reyantonalvaro/ELE0124CL/power_buck/ELE0124CL_power_buck/ELE0124CL_power_buck.kicad_pcb

## KiCad design power_buck/ELE0124CL_power_buck/ELE0124CL_power_buck.kicad_pcb (2024-08-10)

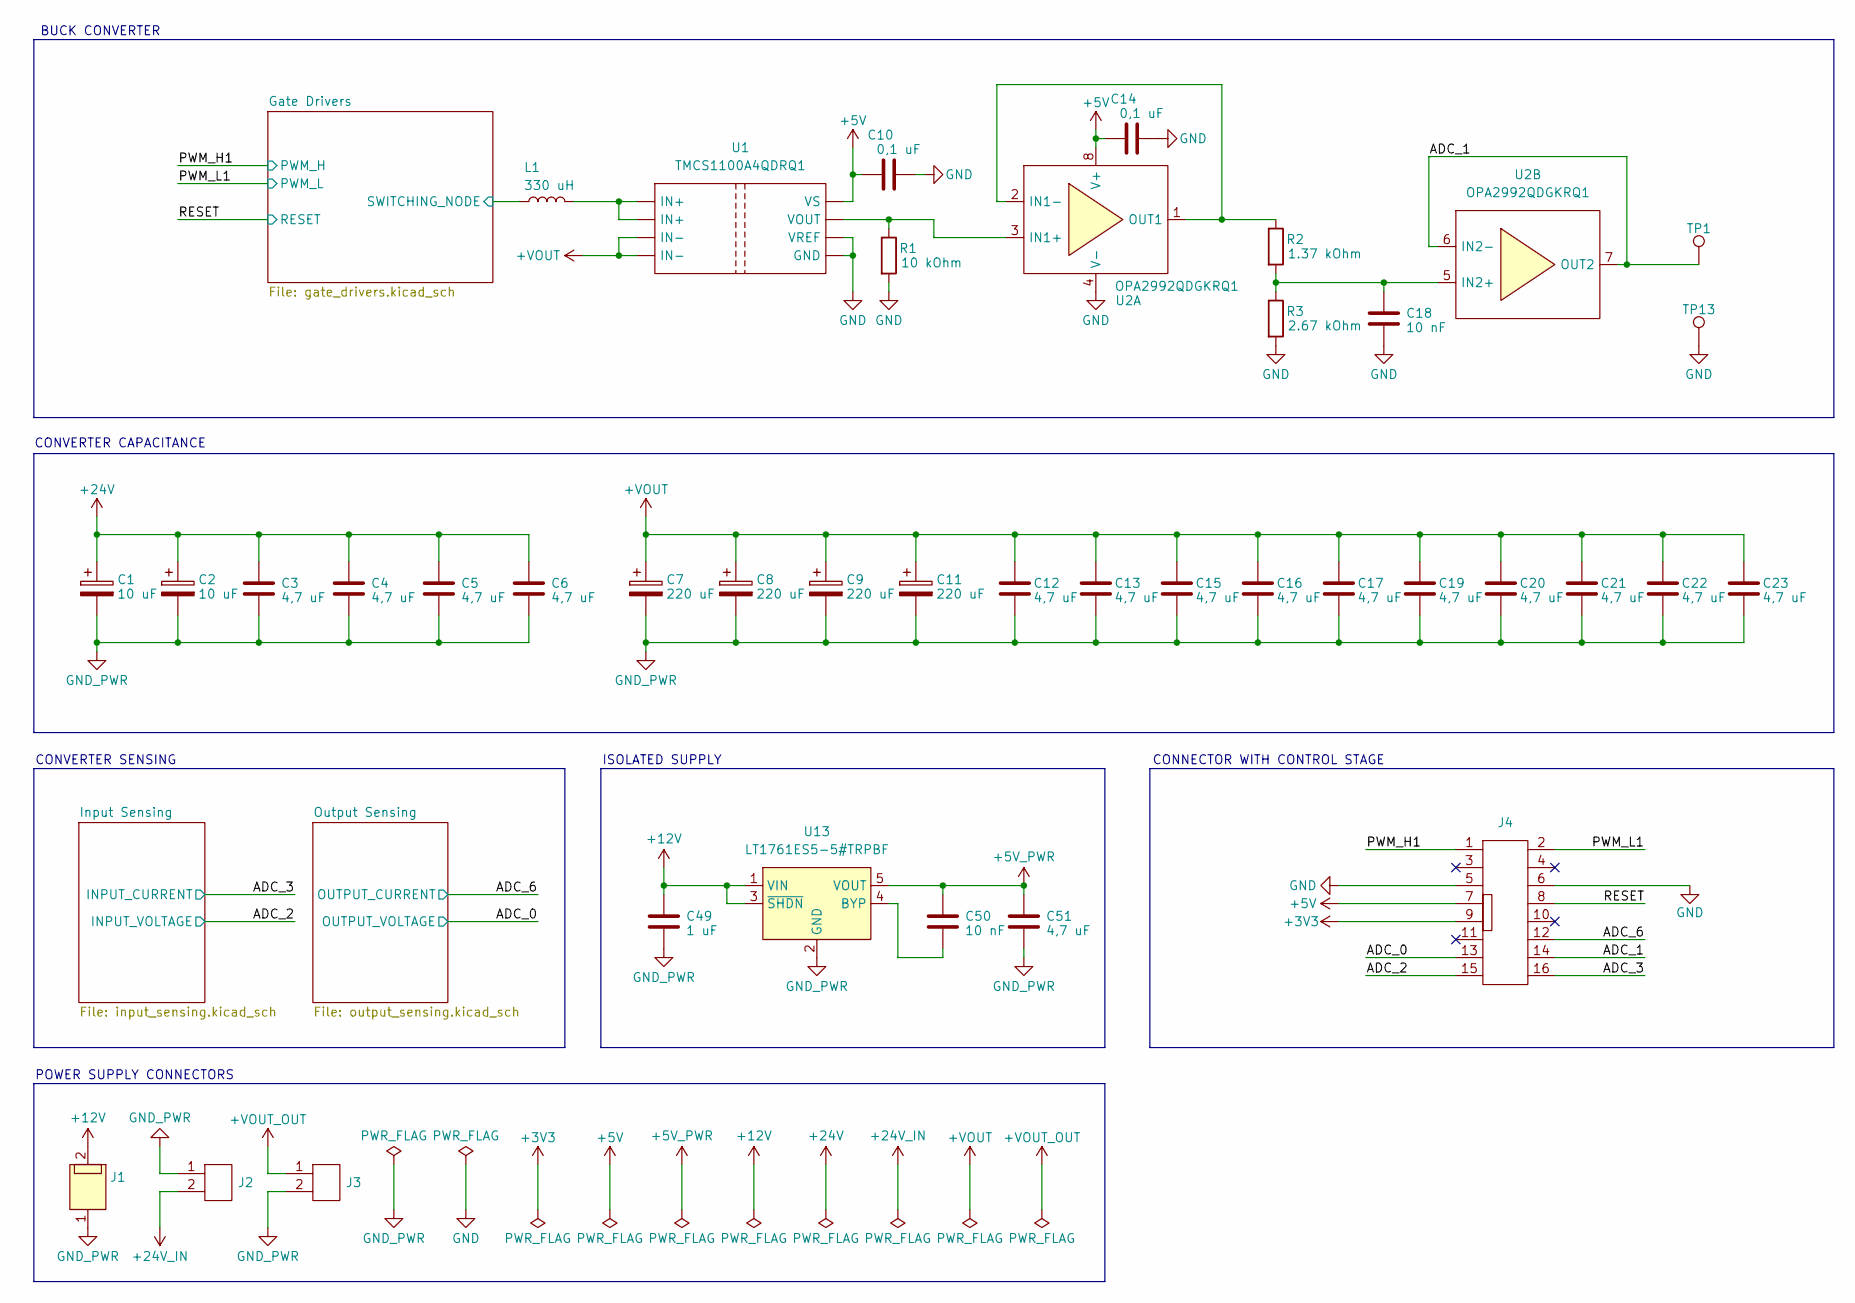
[picture p1: schematic ELE0124CL_power_buck.kicad_sch, ELE0124CL Power Buck Development Kit]

Parts:
C1, C2: 10 uF; C_D5.0mm_H11.0mm_P2.00mm
C3, C4, C5, C6, C12, C13, C15, C16, C17, C19, C20, C21, C22, C23, C51: 4,7 uF; C_1206_3216Metric
C7, C8, C9, C11: 220 uF; C_D10.0mm_H16.0mm_P5.00mm
C10, C14: 0,1 uF; C_0603_1608Metric
C18, C50: 10 nF; C_0603_1608Metric
C49: 1 uF; C_1206_3216Metric
J1: 43045-0212; CONN_SOCKET_1x02_P3.00mm_Vertical
J2, J3: MSTBVA 2,5/ 2-G-5,08; CONN_TERMINAL_BLOCK_1x02_P5.08mm_Vertical
J4: 878311620; CONN_SOCKET_2x08_P2.00mm_Vertical
L1: 330 uH; L_74437529203331
R1: 10 kOhm; R_0603_1608Metric
R2: 1.37 kOhm; R_0603_1608Metric
R3: 2.67 kOhm; R_0603_1608Metric
TP1, TP13: TP_THT
U1: TMCS1100A4QDRQ1; SOIC-8_5.40mm_P1.27mm
U2: OPA2992QDGKRQ1; VSSOP-8_4.40mm_P0.65mm
U13: LT1761ES5-5#TRPBF; TSOT-23-5

Connections:
+3V3: J4.9; also elsewhere on the board
+5V: C10.1, C14.1, J4.7, U1.8 (VS), U2.8 (V+); also elsewhere on the board
+5V_PWR: C50.1, C51.1, U13.5 (VOUT); also elsewhere on the board
+12V: C49.1, J1.2, U13.1 (VIN), U13.3 (~SHDN); also elsewhere on the board
+24V: C1.1, C2.1, C3.1, C4.1, C5.1, C6.1; also elsewhere on the board
+24V_IN: J2.2; also elsewhere on the board
+VOUT: C7.1, C8.1, C9.1, C11.1, C12.1, C13.1, C15.1, C16.1, C17.1, C19.1, C20.1, C21.1, C22.1, C23.1, U1.3 (IN-), U1.4 (IN-); also elsewhere on the board
+VOUT_OUT: J3.1; also elsewhere on the board
/ADC_0: J4.13; also elsewhere on the board
/ADC_1: J4.14, TP1.1 (TP), U2.6 (IN2-), U2.7 (OUT2)
/ADC_2: J4.15; also elsewhere on the board
/ADC_3: J4.16; also elsewhere on the board
/ADC_6: J4.12; also elsewhere on the board
/Gate Drivers/SWITCHING_NODE: L1.1; also elsewhere on the board
/PWM_H1: J4.1; also elsewhere on the board
/PWM_L1: J4.2; also elsewhere on the board
/RESET: J4.8; also elsewhere on the board
GND: C10.2, C14.2, C18.2, J4.5, J4.6, R1.2, R3.2, TP13.1 (TP), U1.5 (GND), U1.6 (VREF), U2.4 (V-); also elsewhere on the board
GND_PWR: C1.2, C2.2, C3.2, C4.2, C5.2, C6.2, C7.2, C8.2, C9.2, C11.2, C12.2, C13.2, C15.2, C16.2, C17.2, C19.2, C20.2, C21.2, C22.2, C23.2, C49.2, C51.2, J1.1, J2.1, J3.2, U13.2 (GND); also elsewhere on the board
unnamed: L1.2, U1.1 (IN+), U1.2 (IN+)
unnamed: R1.1, U1.7 (VOUT), U2.3 (IN1+)
unnamed: R2.1, U2.1 (OUT1), U2.2 (IN1-)
unnamed: C18.1, R2.2, R3.1, U2.5 (IN2+)
unnamed: C50.2, U13.4 (BYP)

Notes on the sheet:
CONNECTOR WITH CONTROL STAGE
CONVERTER CAPACITANCE
CONVERTER SENSING
BUCK CONVERTER
ISOLATED SUPPLY
POWER SUPPLY CONNECTORS

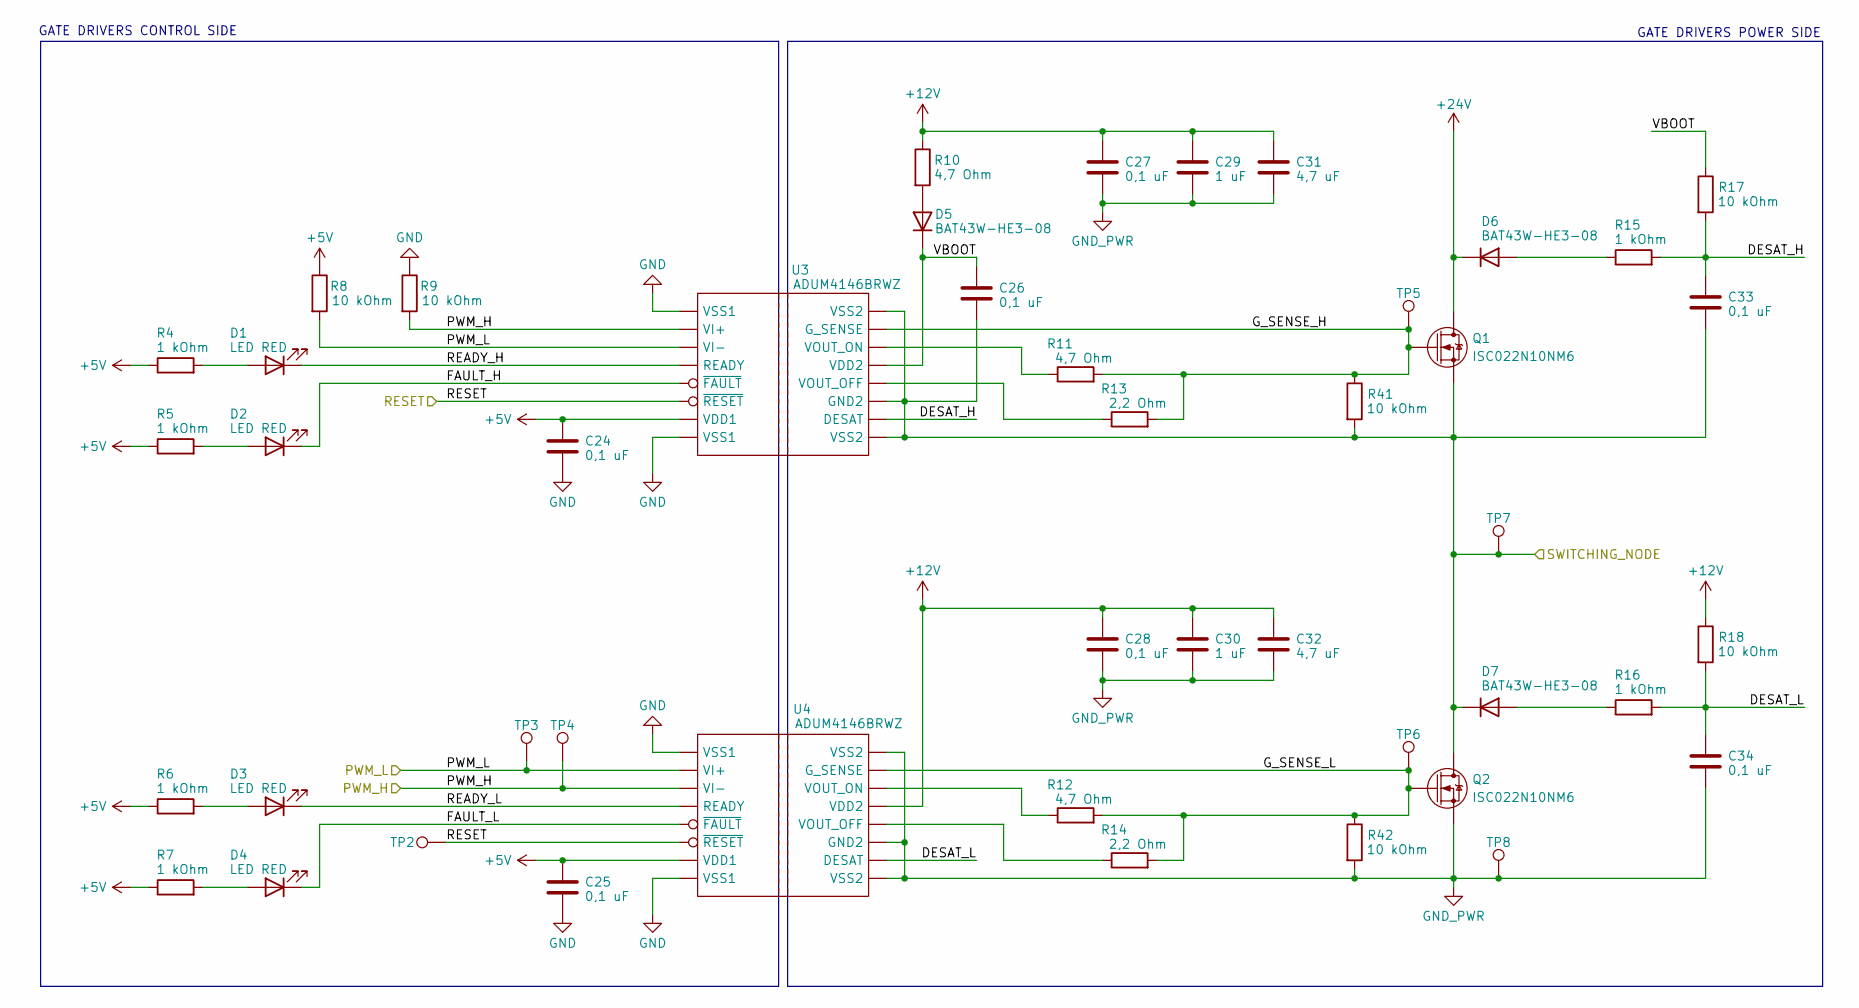
[picture p2: schematic gate_drivers.kicad_sch, ELE0124CL Power Buck Gate Drivers]

Parts:
C24, C25, C27, C28, C33, C34: 0,1 uF; C_0603_1608Metric
C26: 0,1 uF; C_1206_3216Metric
C29, C30: 1 uF; C_1206_3216Metric
C31, C32: 4,7 uF; C_1206_3216Metric
D1, D2, D3, D4: LED RED; D_0603_1608Metric
D5, D6, D7: BAT43W-HE3-08; D_SOD-123
Q1, Q2: ISC022N10NM6; PG-TDSON-8-3
R4, R5, R6, R7, R15, R16: 1 kOhm; R_0603_1608Metric
R8, R9, R17, R18, R41, R42: 10 kOhm; R_0603_1608Metric
R10, R11, R12: 4,7 Ohm; R_2512_6332Metric
R13, R14: 2,2 Ohm; R_2512_6332Metric
TP2, TP3, TP4: TP_D1.0mm
TP5, TP6, TP7, TP8: TP_THT
U3, U4: ADUM4146BRWZ; SOIC-16W_9.60mm_P1.27mm

Connections:
+5V: C24.1, C25.1, R4.1, R5.1, R6.1, R7.1, R8.1, U3.7 (VDD1), U4.7 (VDD1); also elsewhere on the board
+12V: C27.1, C28.1, C29.1, C30.1, C31.1, C32.1, R10.1, R18.1, U4.13 (VDD2); also elsewhere on the board
+24V: D6.1 (K), Q1.3 (D); also elsewhere on the board
/Gate Drivers/DESAT_H: C33.1, R15.2, R17.2, U3.10 (DESAT)
/Gate Drivers/DESAT_L: C34.1, R16.2, R18.2, U4.10 (DESAT)
/Gate Drivers/FAULT_H: D2.1 (K), U3.5 (~FAULT)
/Gate Drivers/FAULT_L: D4.1 (K), U4.5 (~FAULT)
/Gate Drivers/G_SENSE_H: Q1.2 (G), R11.2, R13.2, R41.1, TP5.1 (TP), U3.15 (G_SENSE)
/Gate Drivers/G_SENSE_L: Q2.2 (G), R12.2, R14.2, R42.1, TP6.1 (TP), U4.15 (G_SENSE)
/Gate Drivers/READY_H: D1.1 (K), U3.4 (READY)
/Gate Drivers/READY_L: D3.1 (K), U4.4 (READY)
/Gate Drivers/SWITCHING_NODE: C26.2, C33.2, D7.1 (K), Q1.1 (S), Q2.3 (D), R41.2, TP7.1 (TP), U3.9 (VSS2), U3.11 (GND2), U3.16 (VSS2); also elsewhere on the board
/Gate Drivers/VBOOT: C26.1, D5.1 (K), R17.1, U3.13 (VDD2)
/PWM_H1: R9.2, TP4.1 (TP), U3.2 (VI+), U4.3 (VI-); also elsewhere on the board
/PWM_L1: R8.2, TP3.1 (TP), U3.3 (VI-), U4.2 (VI+); also elsewhere on the board
/RESET: TP2.1 (TP), U3.6 (~RESET), U4.6 (~RESET); also elsewhere on the board
GND: C24.2, C25.2, R9.1, U3.1 (VSS1), U3.8 (VSS1), U4.1 (VSS1), U4.8 (VSS1); also elsewhere on the board
GND_PWR: C27.2, C28.2, C29.2, C30.2, C31.2, C32.2, C34.2, Q2.1 (S), R42.2, TP8.1 (TP), U4.9 (VSS2), U4.11 (GND2), U4.16 (VSS2); also elsewhere on the board
unnamed: D1.2 (A), R4.2
unnamed: D2.2 (A), R5.2
unnamed: D3.2 (A), R6.2
unnamed: D4.2 (A), R7.2
unnamed: D5.2 (A), R10.2
unnamed: D6.2 (A), R15.1
unnamed: D7.2 (A), R16.1
unnamed: R13.1, U3.12 (VOUT_OFF)
unnamed: R11.1, U3.14 (VOUT_ON)
unnamed: R14.1, U4.12 (VOUT_OFF)
unnamed: R12.1, U4.14 (VOUT_ON)

Notes on the sheet:
GATE DRIVERS CONTROL SIDE
GATE DRIVERS POWER SIDE

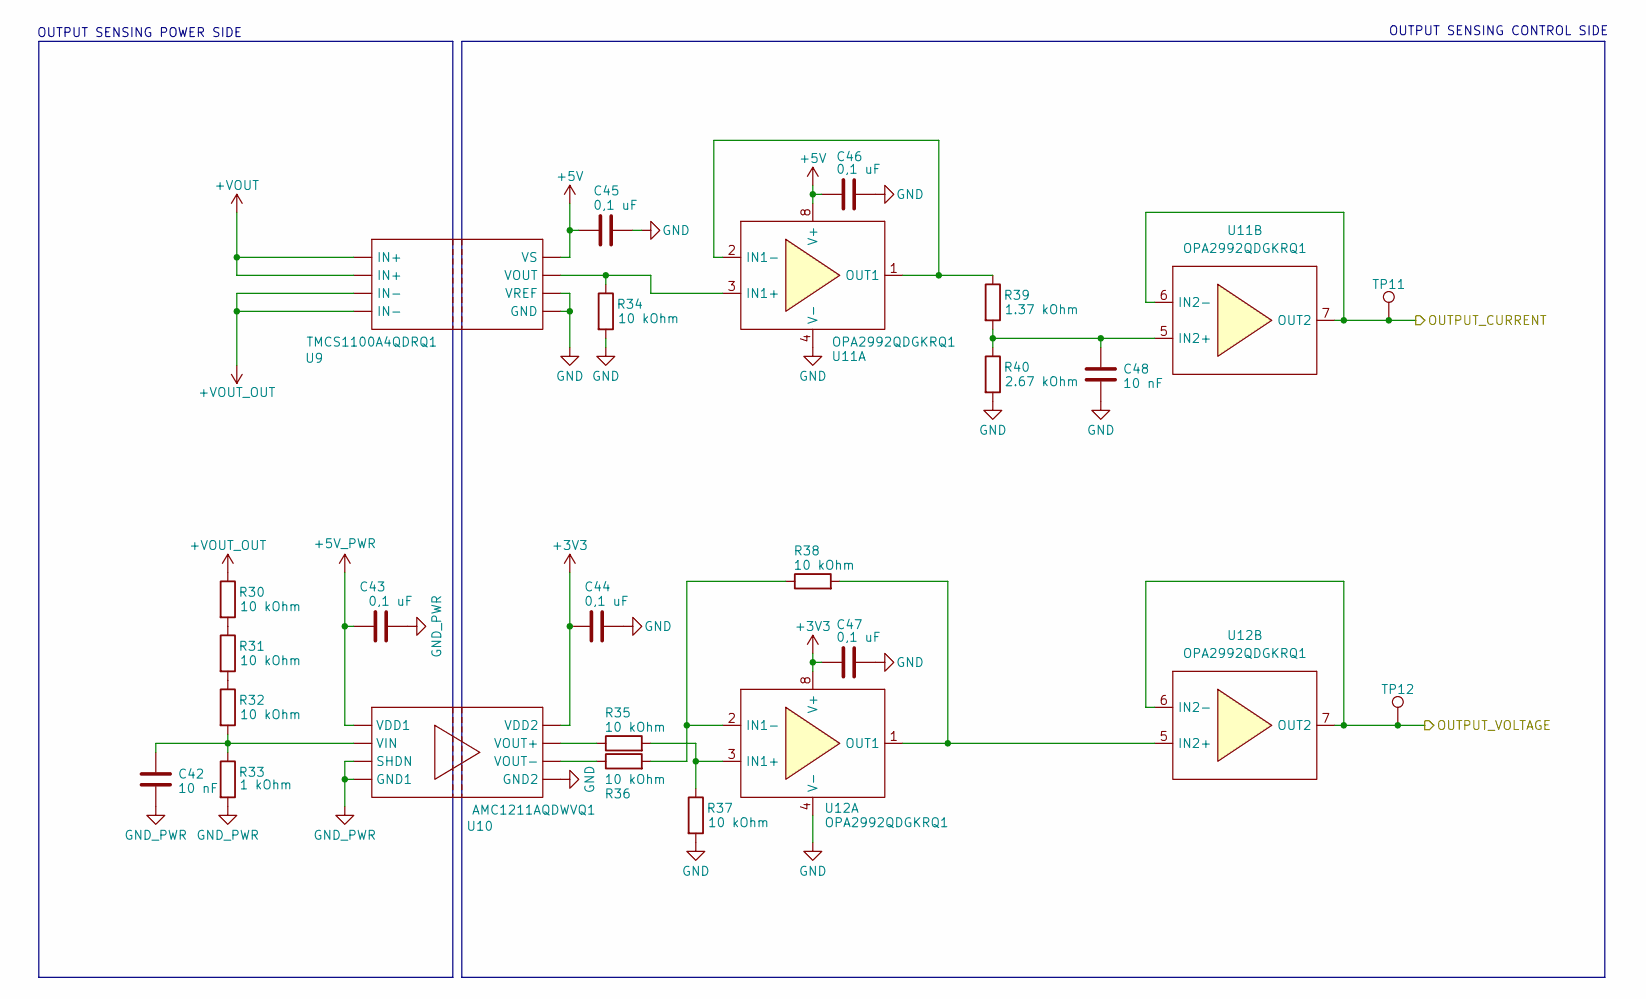
[picture p3: schematic output_sensing.kicad_sch, ELE0124CL Power Buck Output Sensing]

Parts:
C42, C48: 10 nF; C_0603_1608Metric
C43, C44, C45, C46, C47: 0,1 uF; C_0603_1608Metric
R30, R31, R32, R34, R35, R36, R37, R38: 10 kOhm; R_0603_1608Metric
R33: 1 kOhm; R_0603_1608Metric
R39: 1.37 kOhm; R_0603_1608Metric
R40: 2.67 kOhm; R_0603_1608Metric
TP11, TP12: TP_D1.0mm
U9: TMCS1100A4QDRQ1; SOIC-8_5.40mm_P1.27mm
U10: AMC1211AQDWVQ1; SSO-8_10.80mm_P1.27mm
U11, U12: OPA2992QDGKRQ1; VSSOP-8_4.40mm_P0.65mm

Connections:
+3V3: C44.1, C47.1, U10.8 (VDD2), U12.8 (V+); also elsewhere on the board
+5V: C45.1, C46.1, U9.8 (VS), U11.8 (V+); also elsewhere on the board
+5V_PWR: C43.1, U10.1 (VDD1); also elsewhere on the board
+VOUT: U9.1 (IN+), U9.2 (IN+); also elsewhere on the board
+VOUT_OUT: R30.1, U9.3 (IN-), U9.4 (IN-); also elsewhere on the board
/ADC_0: TP12.1 (TP), U12.6 (IN2-), U12.7 (OUT2); also elsewhere on the board
/ADC_6: TP11.1 (TP), U11.6 (IN2-), U11.7 (OUT2); also elsewhere on the board
GND: C44.2, C45.2, C46.2, C47.2, C48.2, R34.2, R37.2, R40.2, U9.5 (GND), U9.6 (VREF), U10.5 (GND2), U11.4 (V-), U12.4 (V-); also elsewhere on the board
GND_PWR: C42.2, C43.2, R33.2, U10.3 (SHDN), U10.4 (GND1); also elsewhere on the board
unnamed: R30.2, R31.1
unnamed: R31.2, R32.1
unnamed: C42.1, R32.2, R33.1, U10.2 (VIN)
unnamed: R35.1, U10.7 (VOUT+)
unnamed: R36.1, U10.6 (VOUT-)
unnamed: R34.1, U9.7 (VOUT), U11.3 (IN1+)
unnamed: R39.1, U11.1 (OUT1), U11.2 (IN1-)
unnamed: C48.1, R39.2, R40.1, U11.5 (IN2+)
unnamed: R35.2, R37.1, U12.3 (IN1+)
unnamed: R36.2, R38.1, U12.2 (IN1-)
unnamed: R38.2, U12.1 (OUT1), U12.5 (IN2+)

Notes on the sheet:
OUTPUT SENSING POWER SIDE
OUTPUT SENSING CONTROL SIDE

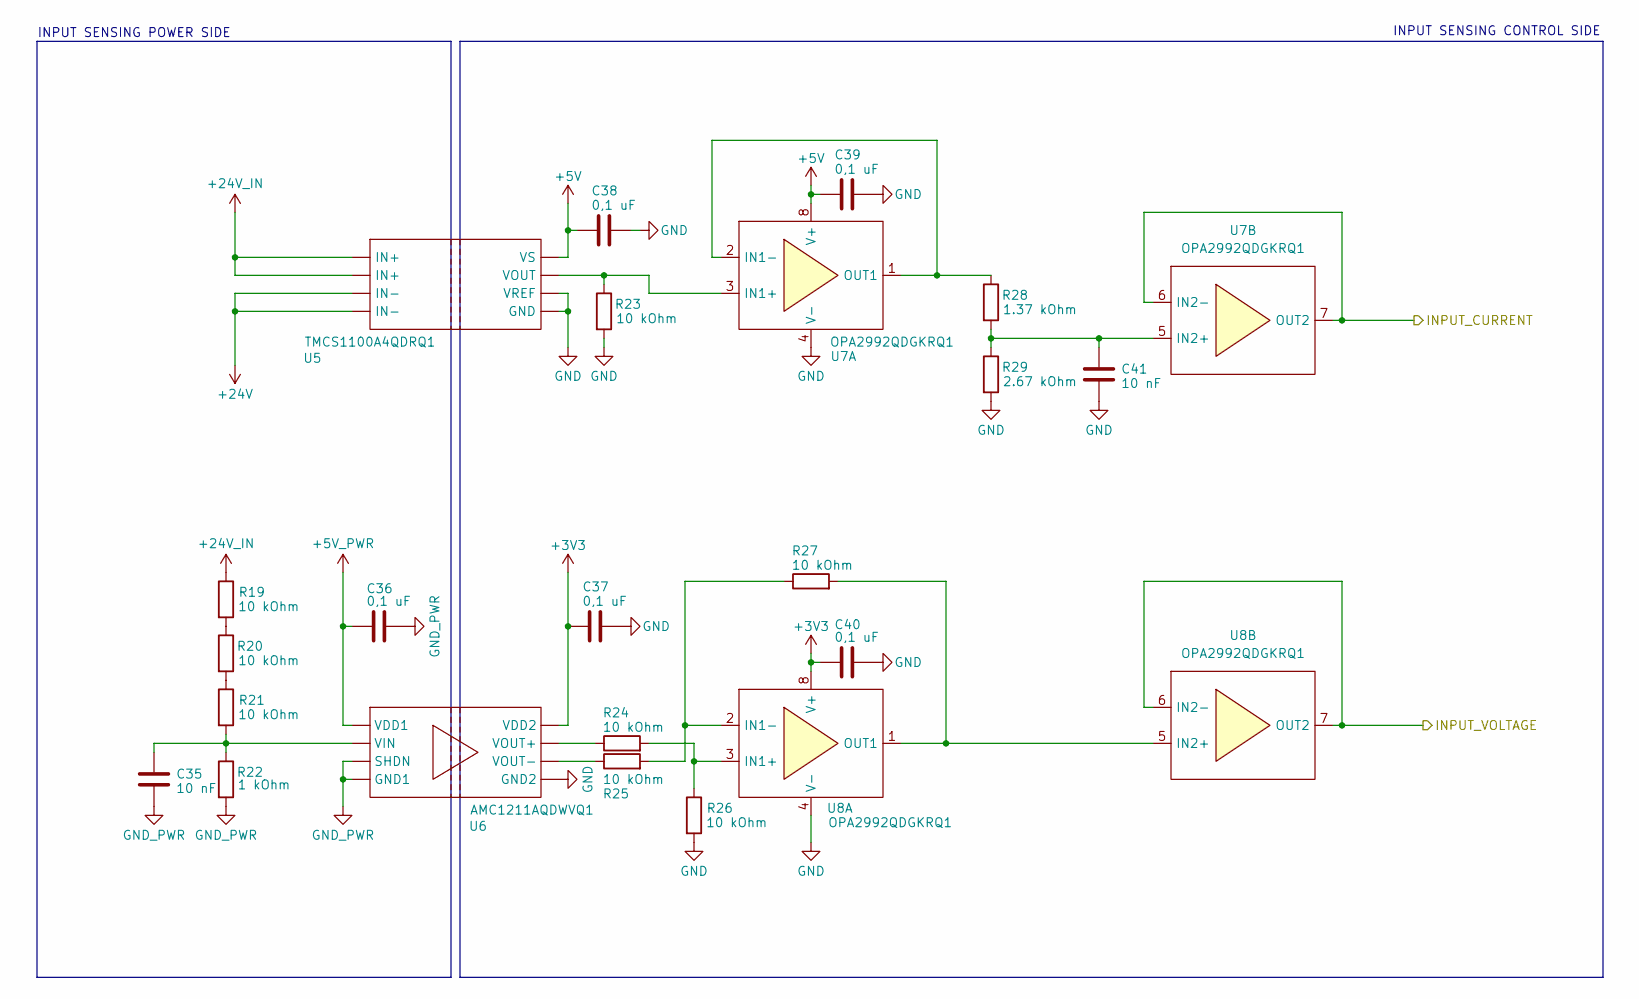
[picture p4: schematic input_sensing.kicad_sch, ELE0124CL Power Buck Input Sensing]

Parts:
C35, C41: 10 nF; C_0603_1608Metric
C36, C37, C38, C39, C40: 0,1 uF; C_0603_1608Metric
R19, R20, R21, R23, R24, R25, R26, R27: 10 kOhm; R_0603_1608Metric
R22: 1 kOhm; R_0603_1608Metric
R28: 1.37 kOhm; R_0603_1608Metric
R29: 2.67 kOhm; R_0603_1608Metric
U5: TMCS1100A4QDRQ1; SOIC-8_5.40mm_P1.27mm
U6: AMC1211AQDWVQ1; SSO-8_10.80mm_P1.27mm
U7, U8: OPA2992QDGKRQ1; VSSOP-8_4.40mm_P0.65mm

Connections:
+3V3: C37.1, C40.1, U6.8 (VDD2), U8.8 (V+); also elsewhere on the board
+5V: C38.1, C39.1, U5.8 (VS), U7.8 (V+); also elsewhere on the board
+5V_PWR: C36.1, U6.1 (VDD1); also elsewhere on the board
+24V: U5.3 (IN-), U5.4 (IN-); also elsewhere on the board
+24V_IN: R19.1, U5.1 (IN+), U5.2 (IN+); also elsewhere on the board
/ADC_2: U8.6 (IN2-), U8.7 (OUT2); also elsewhere on the board
/ADC_3: U7.6 (IN2-), U7.7 (OUT2); also elsewhere on the board
GND: C37.2, C38.2, C39.2, C40.2, C41.2, R23.2, R26.2, R29.2, U5.5 (GND), U5.6 (VREF), U6.5 (GND2), U7.4 (V-), U8.4 (V-); also elsewhere on the board
GND_PWR: C35.2, C36.2, R22.2, U6.3 (SHDN), U6.4 (GND1); also elsewhere on the board
unnamed: R19.2, R20.1
unnamed: R20.2, R21.1
unnamed: R23.1, U5.7 (VOUT), U7.3 (IN1+)
unnamed: C35.1, R21.2, R22.1, U6.2 (VIN)
unnamed: R24.1, U6.7 (VOUT+)
unnamed: R25.1, U6.6 (VOUT-)
unnamed: R28.1, U7.1 (OUT1), U7.2 (IN1-)
unnamed: C41.1, R28.2, R29.1, U7.5 (IN2+)
unnamed: R24.2, R26.1, U8.3 (IN1+)
unnamed: R25.2, R27.1, U8.2 (IN1-)
unnamed: R27.2, U8.1 (OUT1), U8.5 (IN2+)

Notes on the sheet:
INPUT SENSING POWER SIDE
INPUT SENSING CONTROL SIDE

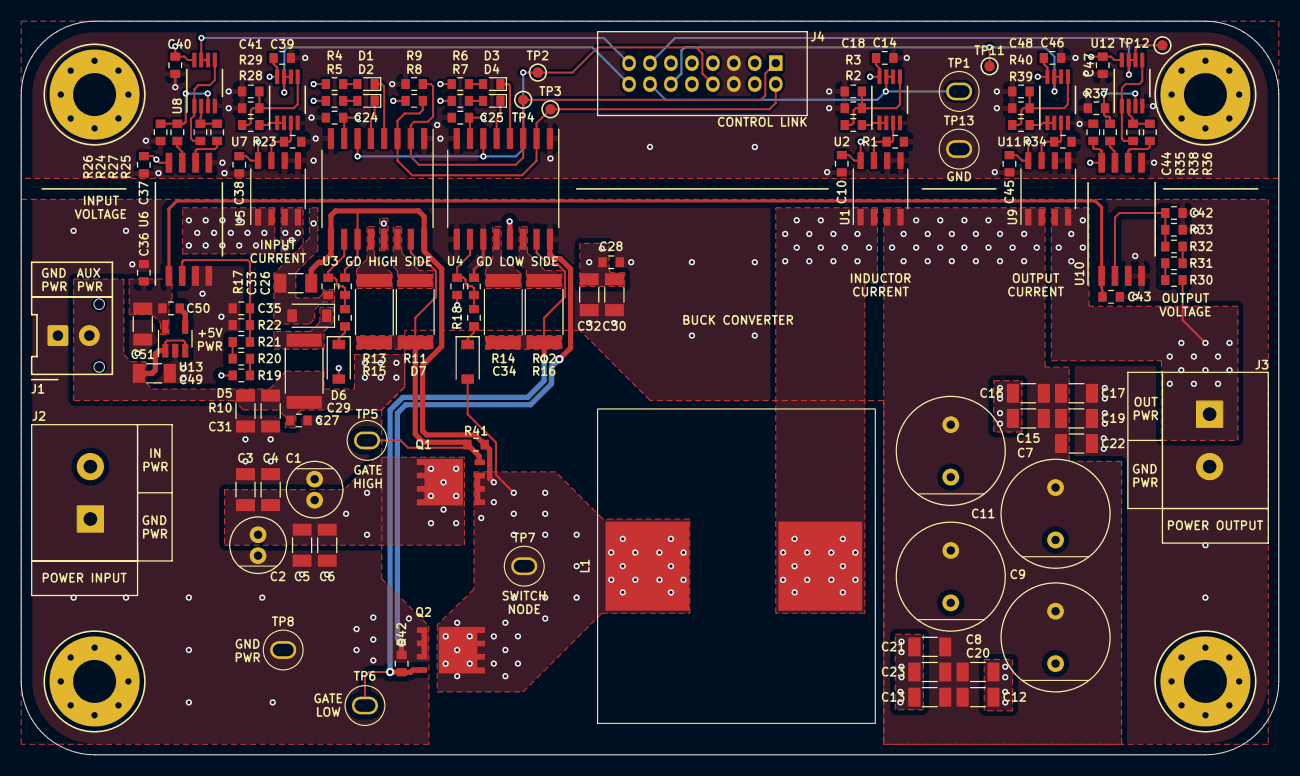
[picture p5: board ELE0124CL_power_buck.kicad_pcb from above]

Board: 4 copper layers, 120.0 x 70.0 mm, 131 parts (0 on the bottom side), 66 nets.
