reyantonalvaro/ELE0124CL/control/ELE0124CL_control/ELE0124CL_control.kicad_pcb

## KiCad design control/ELE0124CL_control/ELE0124CL_control.kicad_pcb (2024-08-10)

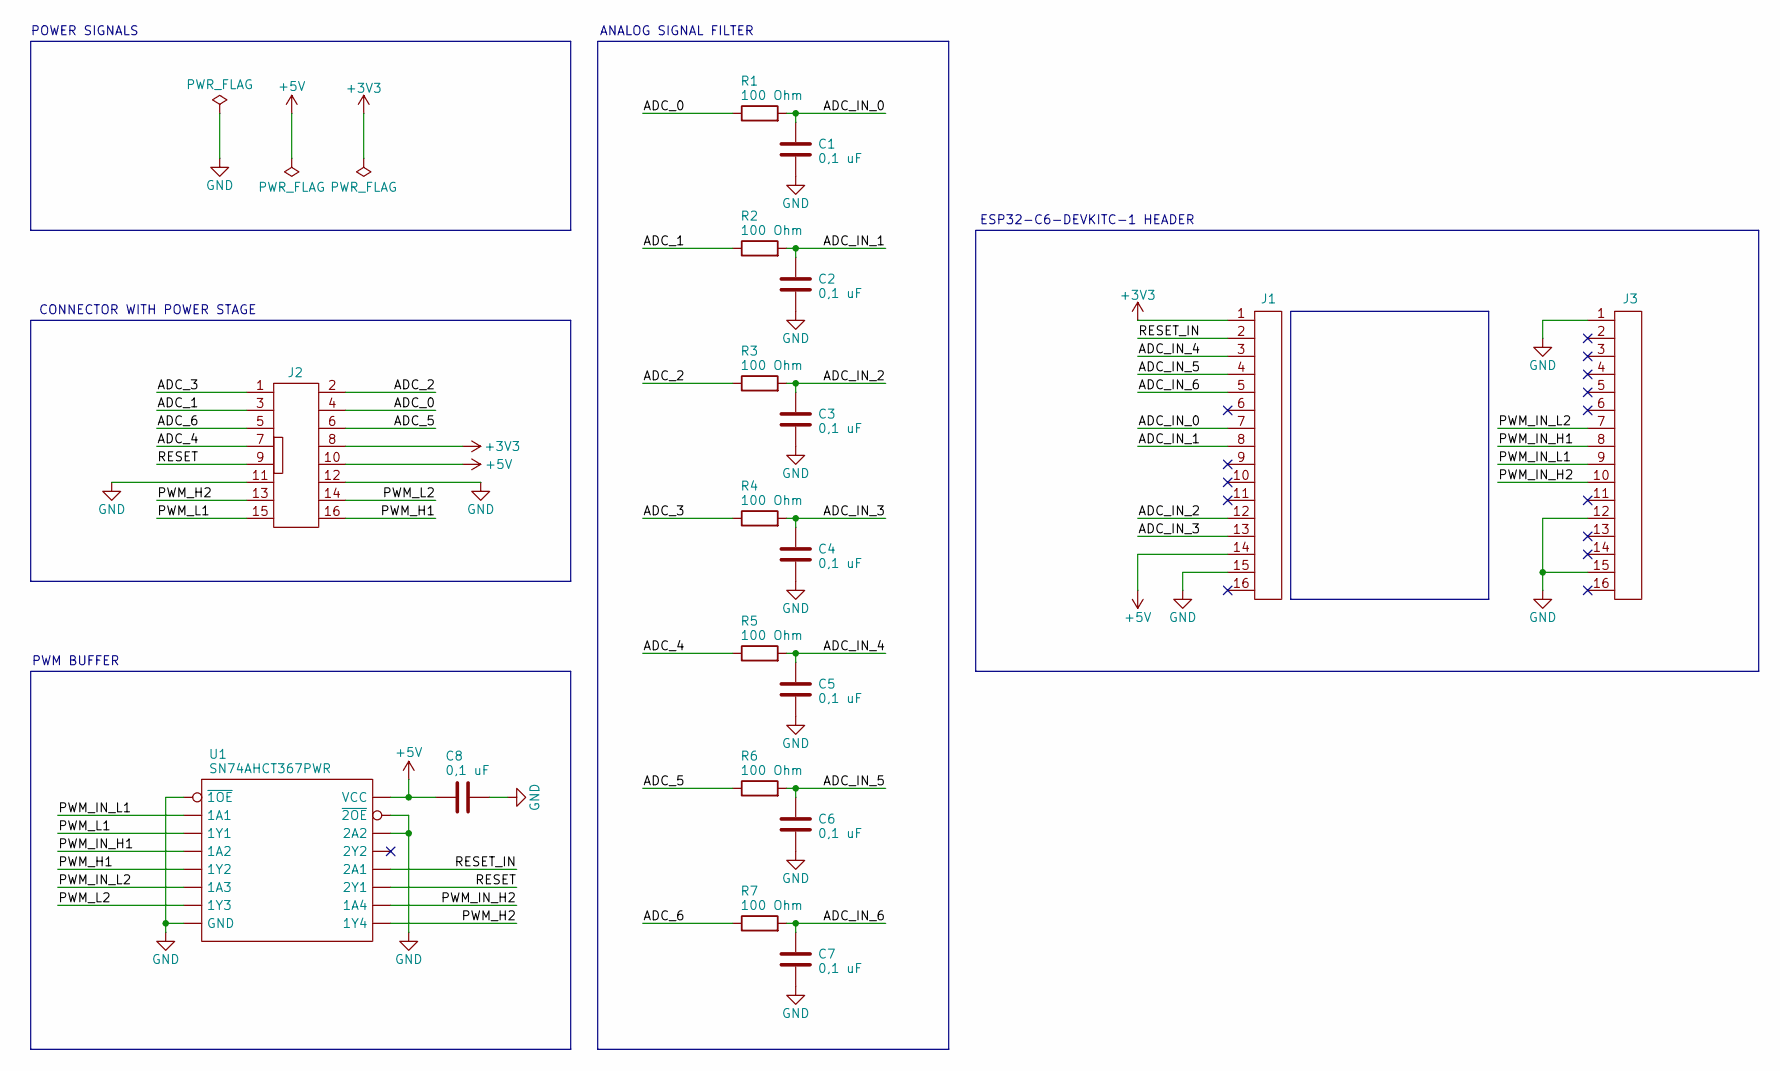
[picture p6: schematic ELE0124CL_control.kicad_sch, ELE0124CL Control Development Kit]

Parts:
C1, C2, C3, C4, C5, C6, C7, C8: 0,1 uF; C_0603_1608Metric
J1, J3: M20-7821646; CONN_SOCKET_1x16_P2.54mm_Vertical
J2: 878311620; CONN_SOCKET_2x08_P2.00mm_Vertical
R1, R2, R3, R4, R5, R6, R7: 100 Ohm; R_0603_1608Metric
U1: SN74AHCT367PWR; TSSOP-16_5.80mm_P0.65mm

Connections:
+3V3: J1.1, J2.8
+5V: C8.1, J1.14, J2.10, U1.16 (VCC)
/ADC_0: J2.4, R1.1
/ADC_1: J2.3, R2.1
/ADC_2: J2.2, R3.1
/ADC_3: J2.1, R4.1
/ADC_4: J2.7, R5.1
/ADC_5: J2.6, R6.1
/ADC_6: J2.5, R7.1
/ADC_IN_0: C1.1, J1.7, R1.2
/ADC_IN_1: C2.1, J1.8, R2.2
/ADC_IN_2: C3.1, J1.12, R3.2
/ADC_IN_3: C4.1, J1.13, R4.2
/ADC_IN_4: C5.1, J1.3, R5.2
/ADC_IN_5: C6.1, J1.4, R6.2
/ADC_IN_6: C7.1, J1.5, R7.2
/PWM_H1: J2.16, U1.5 (1Y2)
/PWM_H2: J2.13, U1.9 (1Y4)
/PWM_IN_H1: J3.8, U1.4 (1A2)
/PWM_IN_H2: J3.10, U1.10 (1A4)
/PWM_IN_L1: J3.9, U1.2 (1A1)
/PWM_IN_L2: J3.7, U1.6 (1A3)
/PWM_L1: J2.15, U1.3 (1Y1)
/PWM_L2: J2.14, U1.7 (1Y3)
/RESET: J2.9, U1.11 (2Y1)
/RESET_IN: J1.2, U1.12 (2A1)
GND: C1.2, C2.2, C3.2, C4.2, C5.2, C6.2, C7.2, C8.2, J1.15, J2.11, J2.12, J3.1, J3.12, J3.15, U1.1 (~1OE), U1.8 (GND), U1.14 (2A2), U1.15 (~2OE)

Notes on the sheet:
CONNECTOR WITH POWER STAGE
ESP32-C6-DEVKITC-1 HEADER
PWM BUFFER
ANALOG SIGNAL FILTER
POWER SIGNALS

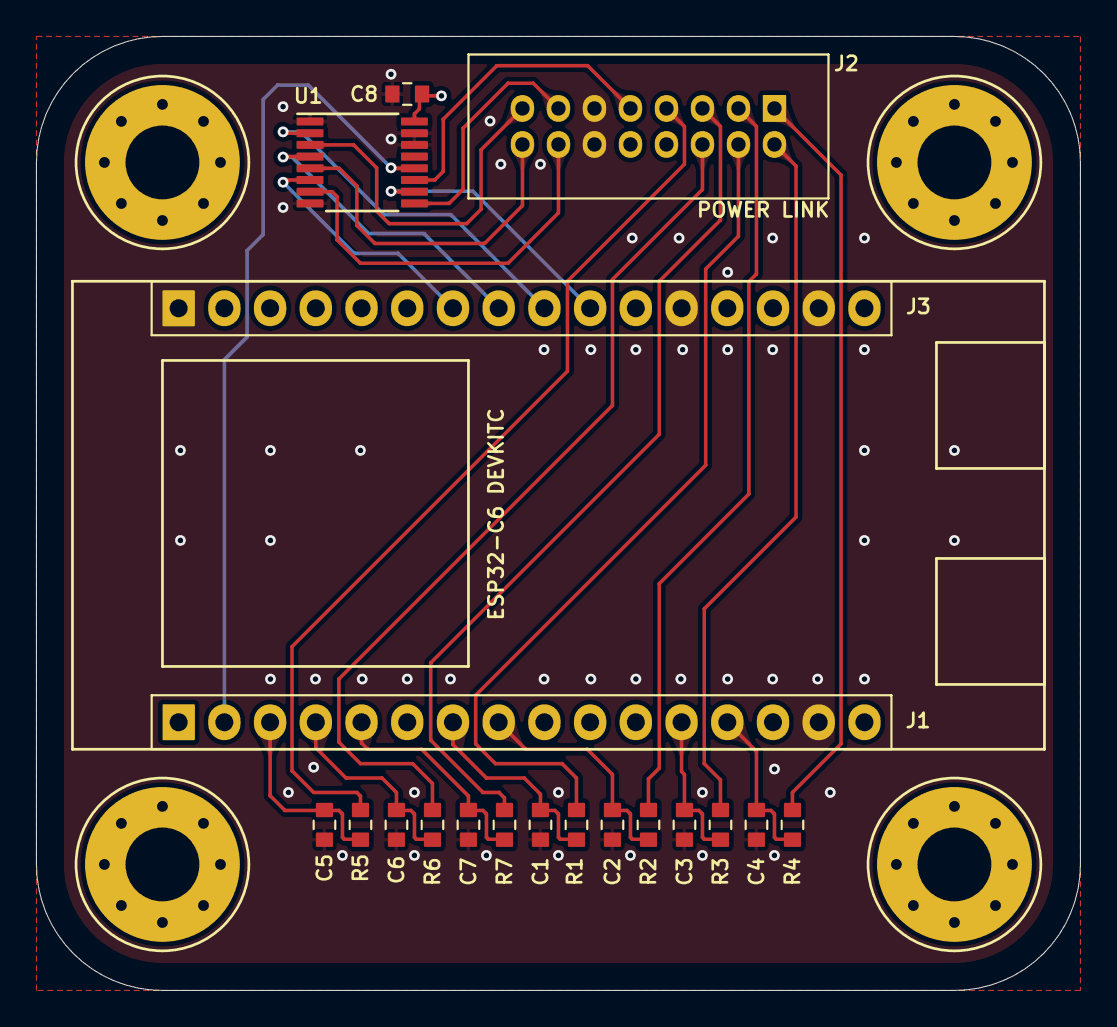
[picture p7: board ELE0124CL_control.kicad_pcb from above]

Board: 4 copper layers, 58.0 x 53.0 mm, 19 parts (0 on the bottom side), 27 nets.
